Rutger505/motorized-blinds/(commit log)

2026-09-30 Update README with project description
    Added project description for motorized blinds.
2026-09-30 Generate driver project
2026-10-07 Turn the repository into a Cargo workspace
    Driver, remote and a new protocol crate share one lockfile and target
    directory. Target specific runners and flags live in the root cargo
    config, with aliases to build each firmware for its own target. The
    remote example now pulls its dependencies from crates.io and links for
    the UF2 bootloader layout of the Pro Micro nRF52840.
2026-10-07 Add the shared protocol crate
    Commands, the 3 byte frame, the fixed addresses and a minimal 802.15.4
    MAC codec for data frames and acks. A host test checks that frames
    built by the codec decode with the ieee802154 crate that esp-radio
    uses, so the blind modules can read what the remote sends.
    [lib.rs]
2026-10-07 Add the blind state machine, storage and TMC2209 driver
    Blind follows the state diagram from the design, generic over the
    stepper, endstop and flash so it runs in host tests. Storage appends
    checksummed records over two flash sectors, so saves spread the wear and
    survive a power loss. The TMC2209 is set up over UART for stealthChop
    with the run current and microsteps, and checks its interface counter to
    confirm every write arrived.
    Hardware dependencies only build for the ESP target, so `cargo test-host`
    runs the logic on the host.
2026-10-07 Add the Home Assistant MQTT client
    A small MQTT 3.1.1 client covers what the blind needs at QoS 0:
    connect with a last will, subscribe, publish and ping. It buffers
    received bytes itself, so waiting for a command can be cancelled by a
    select without losing data. HomeAssistant announces the cover, a custom
    position button and the remote's battery through MQTT discovery, and
    maps OPEN, CLOSE, STOP and AANGEPAST to commands.
2026-10-07 Wire up the blind module's tasks
    The motor task runs the Blind state machine and can be interrupted by a
    new command between steps. The radio task receives frames from the
    remote, and the mqtt tasks connect to Wi-Fi and Home Assistant.
    esp-radio can't run Wi-Fi and IEEE 802.15.4 together yet, so the radio
    and mqtt cargo features are mutually exclusive, with radio as the
    default. Build settings such as BLIND_ID and the Wi-Fi credentials come
    from environment variables, with defaults in the cargo config.
2026-10-07 Implement the remote firmware
    Keypad turns the two button columns into commands: up, down and custom
    send on press, and anything with the calibration button is sent once
    the column is released, so the combinations from the design can be told
    apart. In calibration mode holding up or down moves the blind until
    release.
    Sender wraps the frame in an 802.15.4 data frame, waits for the ack and
    resends up to 3 times with the same sequence number, after which the
    LED blinks. The sequence starts at a random value, so a blind doesn't
    drop the first command after a battery swap as a resend. The battery
    level comes from the internal VDDH measurement, and the 32 MHz crystal
    only runs while sending to sp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
    [lib.rs, main.rs]
2026-10-07 Document building and flashing, and check both driver variants in CI
2026-10-08 Give driver and remote their own Cargo workspaces
    A workspace builds for one target, so cargo at the root tried to build
    both firmwares for the host. Each firmware crate is now its own
    workspace with its own lockfile and profiles, and its cargo config sets
    the target and points at the shared target directory. Plain cargo
    commands work inside each crate, and test-host and clippy-host run the
    unit tests on the host. The root workspace keeps protocol.
2026-10-08 Build a UF2 file of the remote for drag and drop flashing
    The Pro Micro's bootloader flashes any UF2 file copied onto its USB
    drive. The new elf2uf2 tool converts the remote's ELF, and `cargo uf2`
    in remote/ builds the release firmware, writes remote.uf2 and copies it
    onto the bootloader drive when that is mounted.
2026-10-08 Flash the remote with cargo run through its UF2 bootloader
    cargo run in remote/ now builds remote.uf2 and copies it onto the
    bootloader drive when mounted, replacing the separate uf2 alias. Flashing
    through a debug probe moves to `cargo probe`.
2026-10-12 Only use serde_json in the host unit tests
    serde_json needs std, so as a dev-dependency for every target it broke
    cargo test on the ESP32-C6.
2026-10-12 Log at debug level on the driver by default
2026-10-12 Ack the remote's frames from the driver
    esp-radio's auto_ack_tx sends acks for received frames; auto_ack_rx,
    which was set, waits for acks to frames the driver sends. The remote
    never got an ack, so it resent every command and blinked its LED.
2026-10-12 Poll for the TMC2209 reply and log the UART exchange
    read_async only wakes on the UART's FIFO interrupts, and the reply was
    never noticed. Reading the FIFO in a loop receives it. At debug level,
    every exchange logs the sent and received bytes, and a timeout tells a
    missing echo (wiring) apart from a missing reply (the TMC2209 itself).
2026-10-16 Add the OpenSCAD model for the remote's case
    A tray with the CR2032 holder in its own bay at the bottom end and the
    board under a button plate, and a lid with the 8 buttons and engraved
    labels, closed with 4 M2 self tapping screws through the lid. The
    holder clips into its pocket and lifts out on its wires to swap the
    cell.
2026-10-16 Add the OpenSCAD model for the driver's case and wall mount
2026-10-26 Add gitignore generated stl
2026-10-27 Split the driver gear in two glued halves and widen the motor boss and shaft bore
    The one piece gear had a flat overhang over the rope groove. It now splits at
    the top of the groove, so neither half needs supports, and two filament dowels
    line the halves up. The boss hole and the shaft bore printed too tight to fit.
2026-10-27 Drop the gear hub and widen the gear by 2 mm
    Without the hub both halves are flat on the outside, so each prints outer face
    down with the bead pockets open upwards. The wider rims bring the shaft grip to
    12.5 mm. The gear's wall face now sits 1 mm closer to the rail, so the nearest
    chain position moves from 15 to 16 mm; the case reaches as close as before.
2026-10-28 Ajust shaft size
2026-10-28 Disable the radio after each send so the remote sleeps again
    embassy leaves the radio in RXIDLE after receiving or cancelling a
    receive, which kept the receiver on at about 10 mA after the first
    button press.
2026-10-28 Print wider
2026-10-29 Drop the motor pads so the motor has 0.4 mm of play instead of a squeeze
2026-10-29 Adjust motor supports and carriage fit
2026-10-30 Move the remote board under the buttons and fix the battery holder pocket
    The board turns crosswise and sits behind the battery, both under the button
    plate, which takes the body from 75.7 to 61.8 mm long. The pocket is 23.3 x 24.3
    mm with a cell in the holder, the back wall is 3 mm lower with a 3 mm slot for
    the ground pin, and the clips sit between the button rows.
2026-10-31 Add a remote print layout without the button plate
2026-10-31 Use the measured CR2032 holder size for the remote pocket
    The holder is 22.7 x 24.1 mm with a cell and 6.1 mm high, 6.3 mm at the centred
    contact tab. The pocket keeps 0.5 mm clearance on the width and 0.3 mm on the
    length, so it becomes 23.2 x 24.4 mm, and the clip lips sit 0.2 mm above the body.
